drewsum/mTouch_Test/README.md

# mTouch_Test
Small PCB for playing around with PIC mTouch capacitive touch methods and USB serial ports

Firmware for U201 written in MPLABX, built using microchip's XC8 compiler

8/12/2018: PCB has been ordered via OSHPark
