drewsum/mTouch_Test/mTouch_Test/mTouch_Test_bom_.xlsx

Component | References | Value | Quantity Per PCB | Datasheet | Digi-Key PN | display_footprint | Dielectric | Voltage | Tolerance | Wattage
1 | C201 C204 C301 C303 C401 C402 C404 C406 C408 C409 C410 C501 C502 C503 C504 | 0.1uF | 15 |  | 399-6856-1-ND | 603 | X7R | 50V
2 | C601 | 100uF | 1 |  | 718-1031-1-ND | 7343 |  | 20V | 10%
3 | C202 C205 | 10nF | 2 |  | 490-4781-1-ND | 603 | X7R | 50V
4 | C203 C206 | 1nF | 2 |  | 399-3293-1-ND | 603 | X7R | 50V
5 | C602 C603 | 1uF | 2 |  | 478-5010-1-ND | 603 | X7R | 16V
6 | C403 | 4.7uF | 1 |  | 445-6969-1-ND | 805 | X7R | 16V
7 | C405 C407 | 47pF | 2 |  | 478-3692-1-ND | 603 | X7R | 50V
8 | C302 | 56000pF | 1 |  | 490-7747-1-ND | 2220 | X7R | 250VAC
9 | D601 | Green | 1 |  | 511-1308-1-ND | 603
10 | D201 D202 D203 D204 D205 D501 | Red | 6 |  | 511-1310-1-ND | 603
11 | D401 | Yellow | 1 |  | 511-1305-1-ND | 603
12 | J601 | Barrel_Jack_Switch | 1 | ~ | SC237-ND
13 | J501 | Prog | 1
14 | J401 | USB_B_Micro | 1 | ~ | 732-5960-1-ND
15 | L401 | 600R 0.5A | 1 | ~ | 732-1593-1-ND
16 | Q501 | BSS214NW | 1 | https://www.infineon.com/dgdl/Infineon-BSS214NW-DS-v02_02-en.pdf?fileId=db3a30431b3e89eb011b695aebc01bde | BSS214NWH6327XTSA1CT-ND
17 | Q601 | Si2319CDS | 1 | http://www.vishay.com/docs/66709/si2319cd.pdf | SI2319CDS-T1-GE3CT-ND
18 | R504 | 0 | 1 |  | P0.0GCT-ND | 603 |  |  | 1% | 1/10W
19 | R506 | 10 | 1 |  | 311-10.0HRCT-ND | 603 |  |  | 1% | 1/10W
20 | R201 R301 R302 R303 R304 R305 R306 R401 R501 R502 R503 R505 R601 | 10k | 13 |  | RHM10KADCT-ND | 603 |  |  | 1% | 1/10W
21 | R207 R208 R209 R210 R211 R404 R507 R602 | 1k | 8 |  | YAG2323CT-ND | 603 |  |  | 1% | 1/10W
22 | R202 R203 R204 R205 R206 | 220 | 5 |  | RHM220DCT-ND | 603 |  |  | 1% | 1/10W
23 | R402 R403 | 27 | 2 |  | P27.0HCT-ND | 603 |  |  | 1% | 1/10W
24 | U401 | 74LVC1G17 | 1 | http://www.ti.com/lit/sg/scyt129e/scyt129e.pdf | 296-16998-1-ND
25 | U502 | 74LVC1G86 | 1 | http://www.ti.com/lit/sg/scyt129e/scyt129e.pdf | 296-9854-1-ND
26 | U402 | FT234XD | 1 | http://www.ftdichip.com/Support/Documents/DataSheets/ICs/DS_FT234XD.pdf | 768-1178-1-ND
27 | U301 | ISO7331C | 1 | http://www.ti.com/lit/ds/symlink/iso7331c.pdf | 296-47261-1-ND
28 | U601 | MCP1700-3302E | 1 | http://ww1.microchip.com/downloads/en/DeviceDoc/20001826C.pdf | MCP1700T3302EMBCT-ND
29 | U201 | PIC18LF67K40-I_PT | 1 |  | PIC18LF67K40T-I/PTCT-ND
30 | U501 | TL331 | 1 | http://www.ti.com/lit/ds/symlink/tl331.pdf | 296-10168-1-ND
31 | U403 | TPD3S014DBVR | 1 | http://www.ti.com/lit/ds/symlink/tpd3s014.pdf | 296-38835-1-ND
32 | Z501 Z601 | BZT52C5V6S | 2 |  | BZT52C5V6S-TPMSCT-ND | SOD323 |  | 5.6V
Component Groups:
Component Count:
Fitted Components:
Number of PCBs:
Total components:
Schematic Version:
Schematic Date:
BoM Date:
Schematic Source:
KiCad Version:
