drewsum/mTouch_Test/(list of files, cad)

Other CAD files:
sfw/U201_Firmware/dist/default/production/U201_Firmware.production.obj
