drewsum/mTouch_Test/mTouch_Test/mTouch_Test.pdf

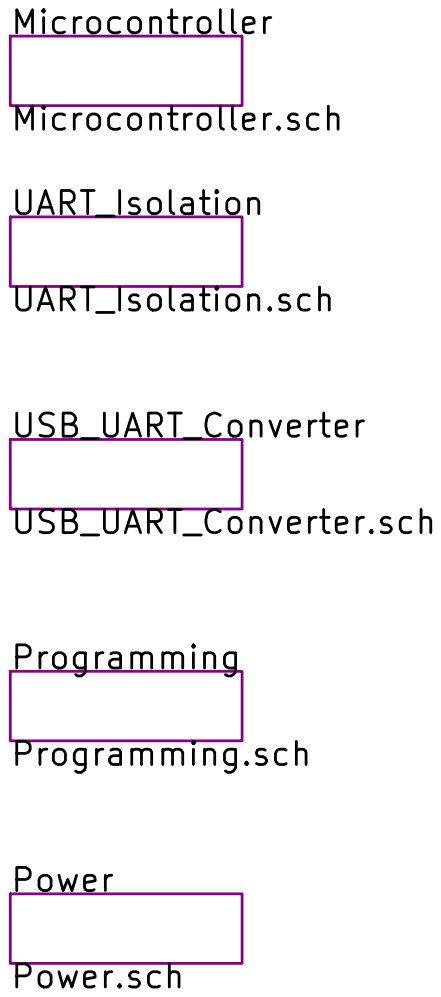
[picture p1: page 1]

Microcontroller Microcontroller.sch UART_Isolation UART_Isolation.sch USB_UART_Converter USB_UART_Converter.sch Programming

Programming.sch Power Power.sch

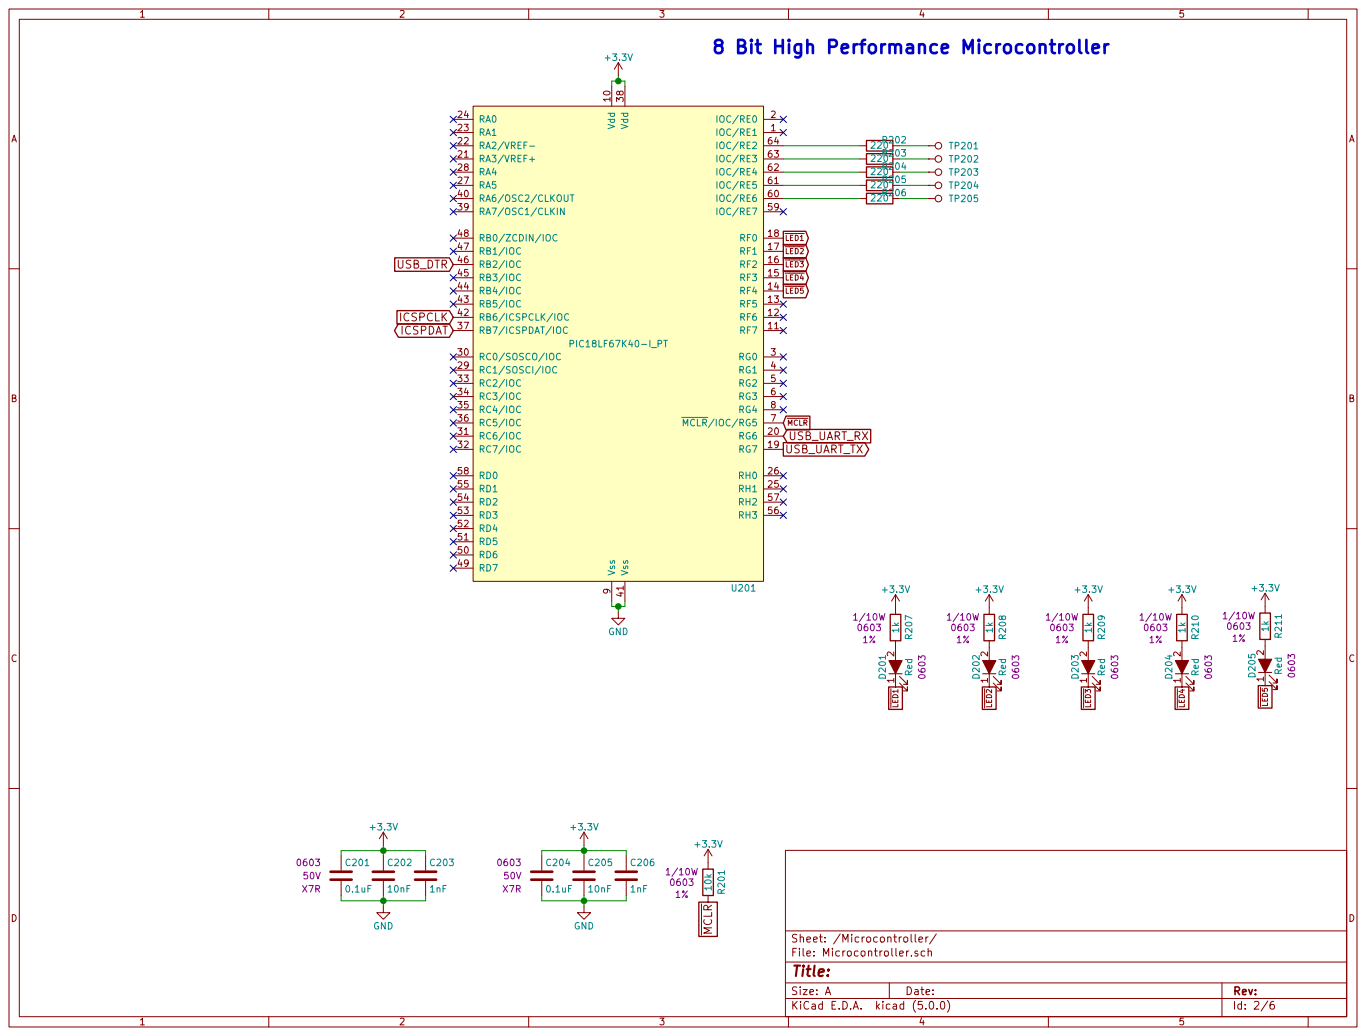
[picture p2: page 2]

8 Bit High Performance Microcontroller

Id: 2/6 Title: File: Microcontroller.sch Sheet: /Microcontroller/

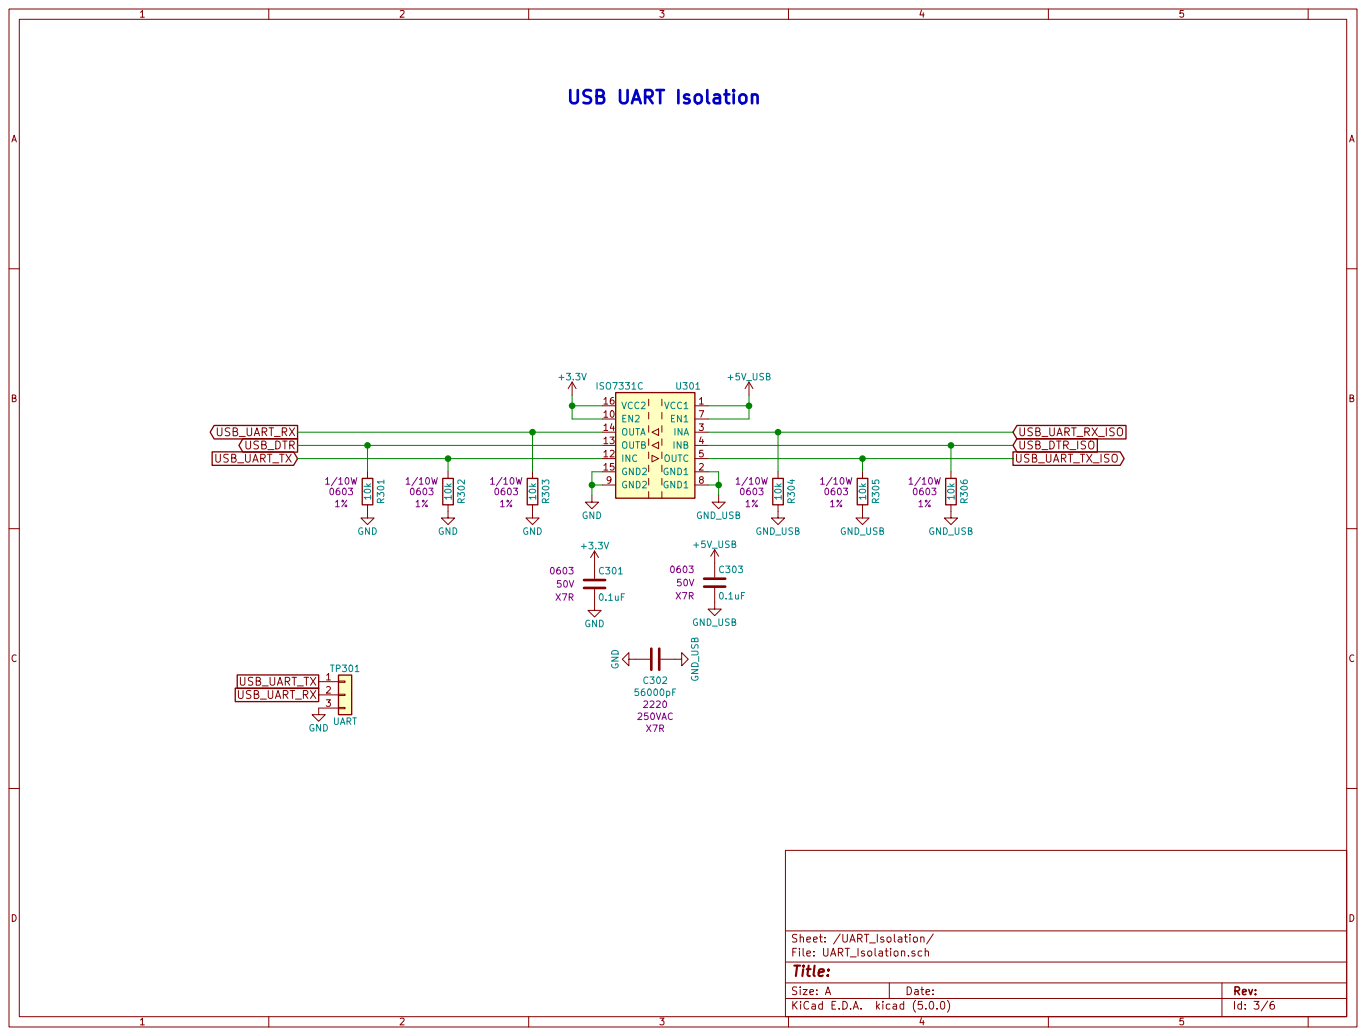
[picture p3: page 3]

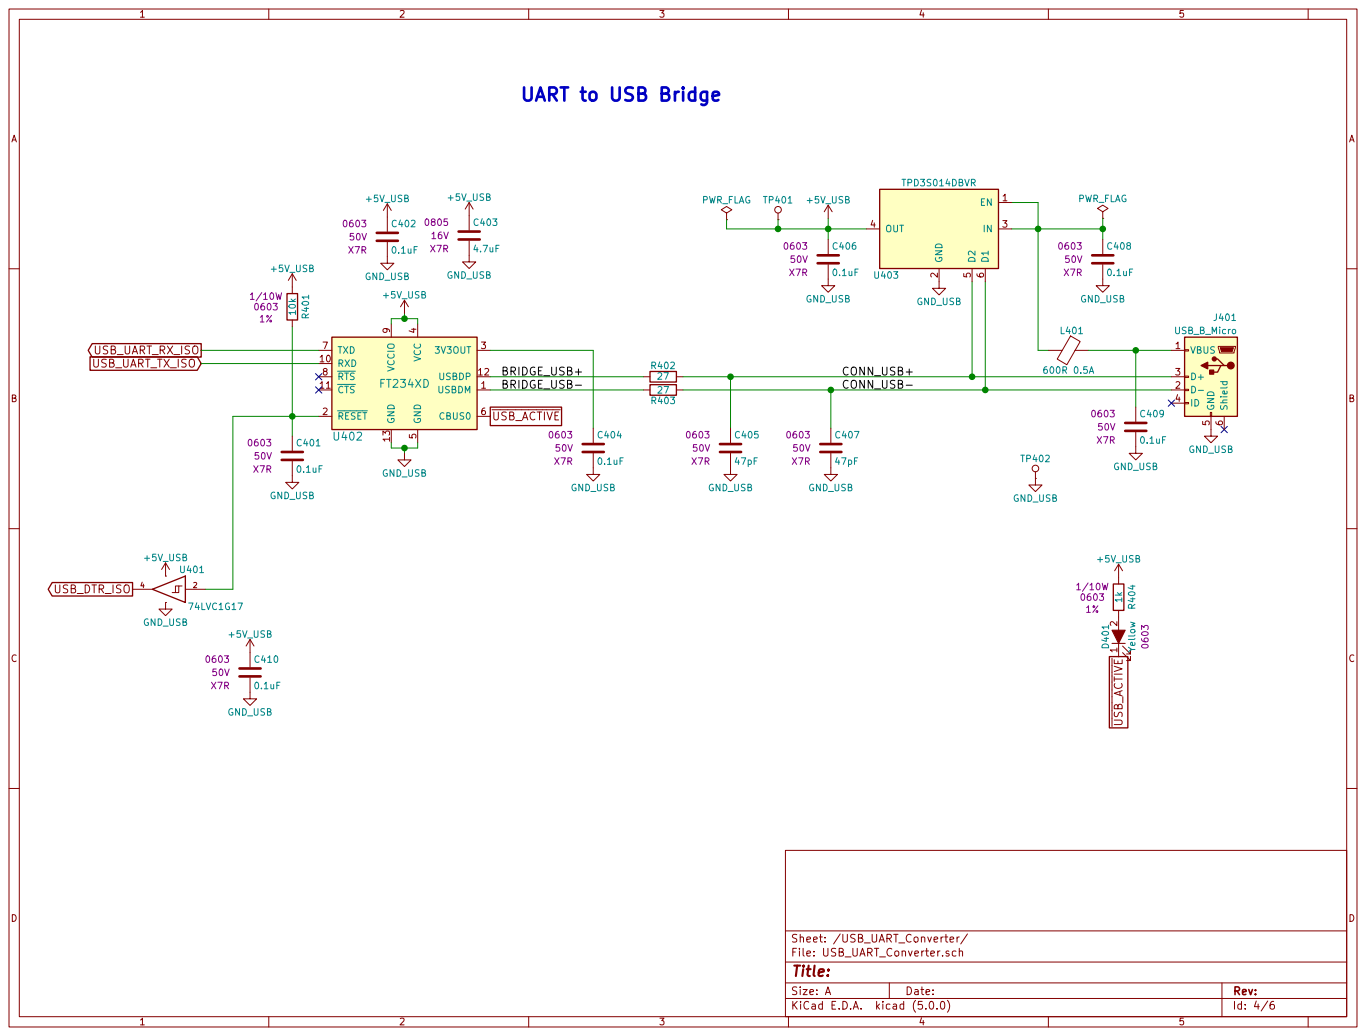
[picture p4: page 4]

J401 USB_B_Micro UART to USB Bridge

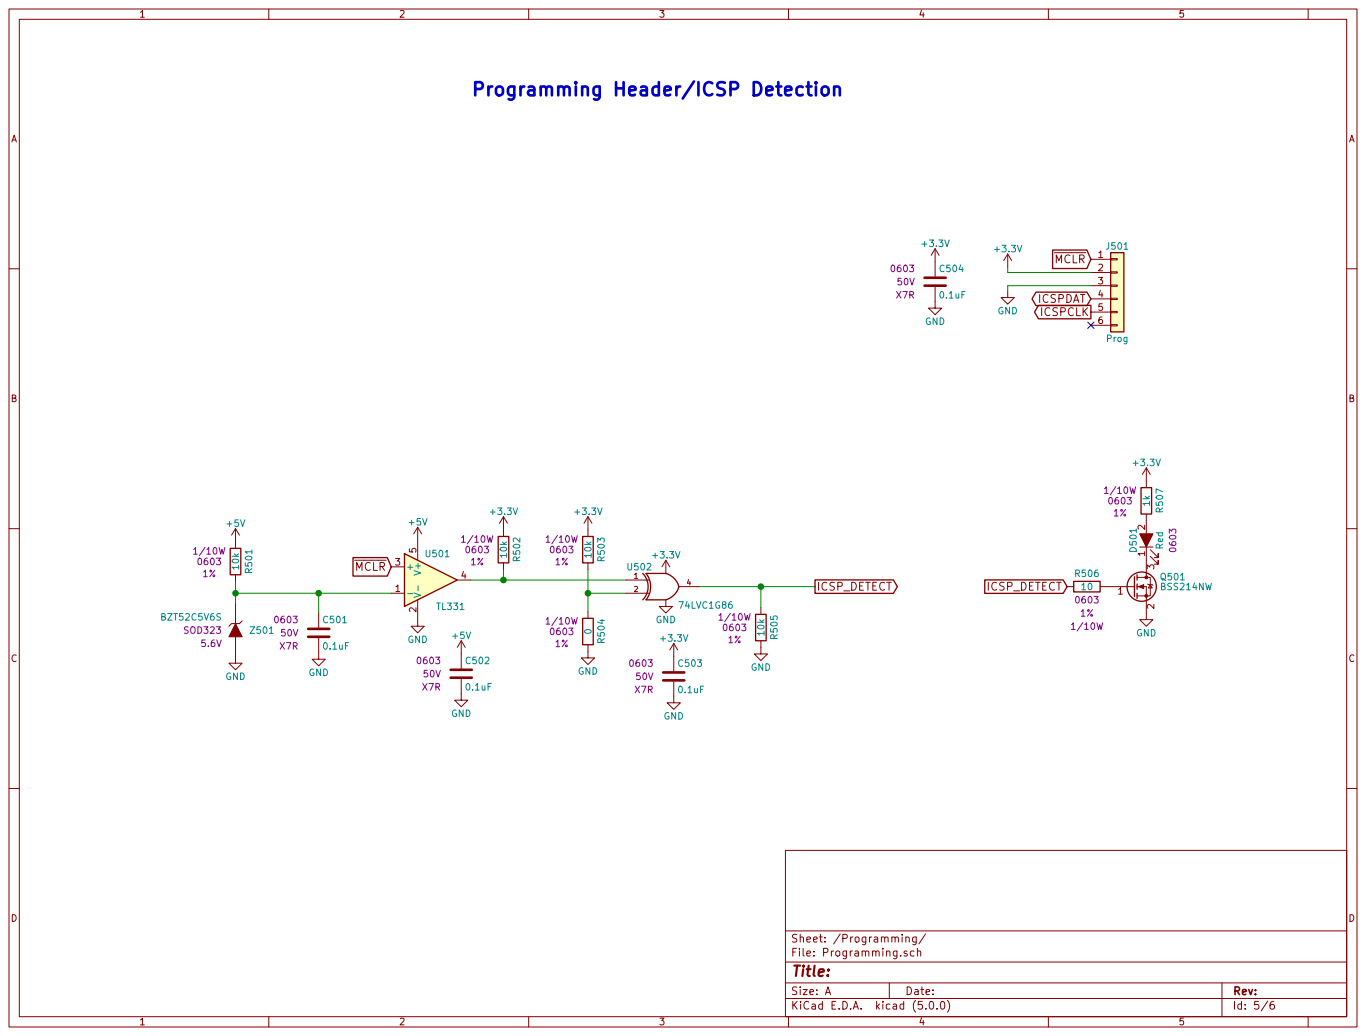
[picture p5: page 5]

74LVC1G86 Programming Header/ICSP Detection

ICSPDAT GND GND MCLR

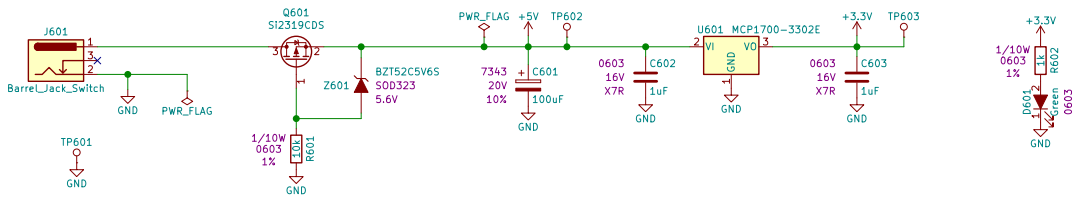
[picture p6: page 6]

Id: 6/6 Title: File: Power.sch Sheet: /Power/
