drewsum/mTouch_Test/mTouch_Test/mTouch_Test.kicad_pcb

## KiCad design mTouch_Test/mTouch_Test.kicad_pcb (2018-08-28)

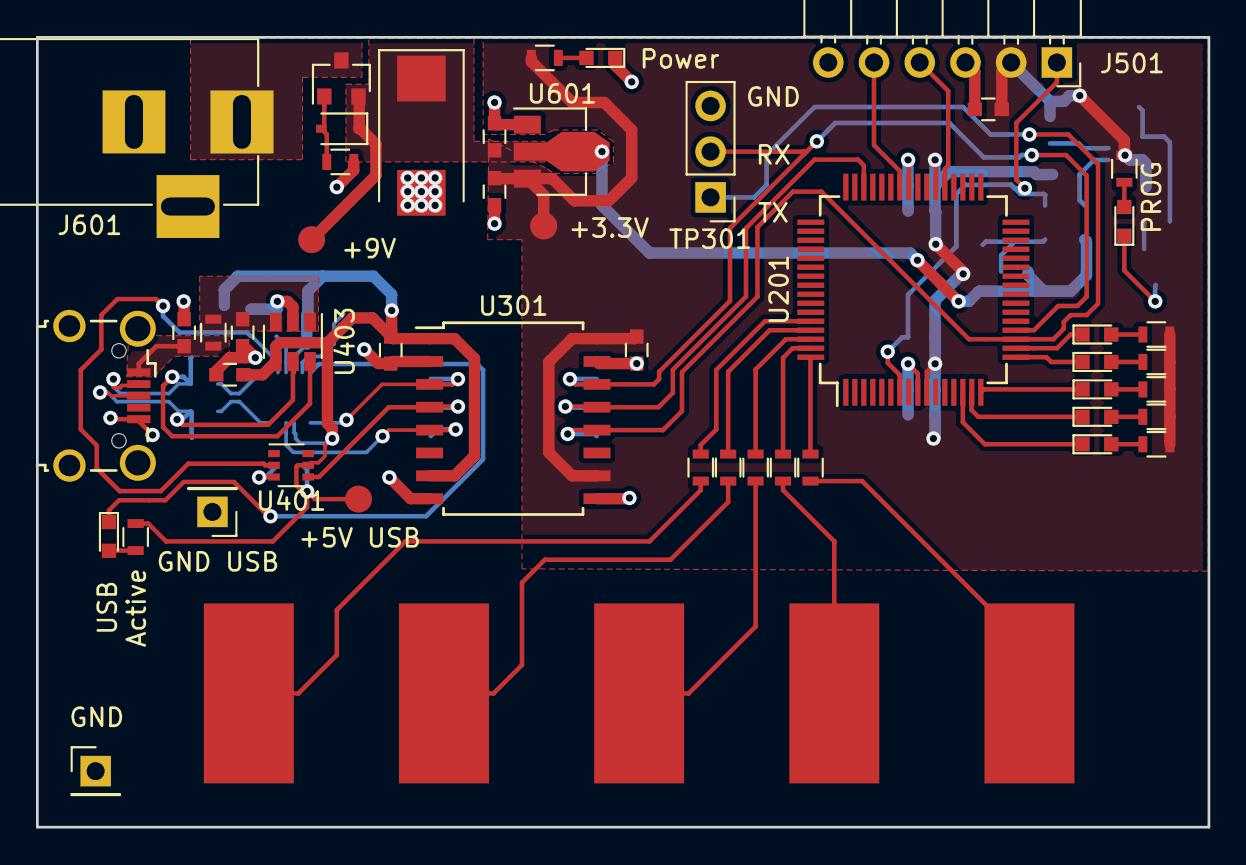
[picture p7: board mTouch_Test.kicad_pcb from above]

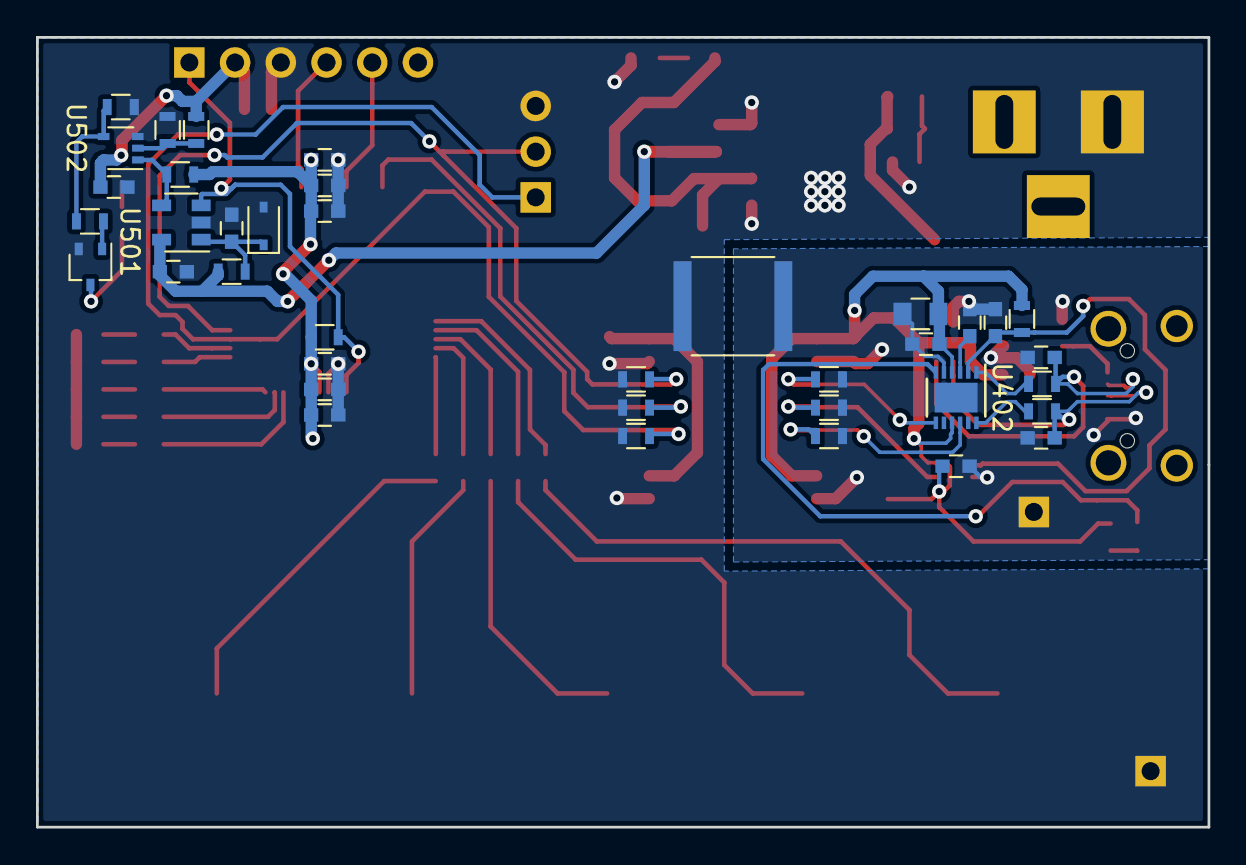
[picture p8: board mTouch_Test.kicad_pcb from below]

Board: 2 copper layers, 65.1 x 43.9 mm, 91 parts (38 on the bottom side), 54 nets.

Parts:
C201, C204, C301, C303, C401, C402, C404, C406, C408, C409, C410, C501, C502, C503, C504: 0.1uF; C_0603
C202, C205: 10nF; C_0603
C203, C206: 1nF; C_0603
C302: 56000pF; C_2220
C403: 4.7uF; C_0805
C405, C407: 47pF; C_0603
C601: 100uF; CP_Tantalum_Case-X_EIA-7343-43_Reflow
C602, C603: 1uF; C_0603
D201, D202, D203, D204, D205, D501: Red; LED_0603
D401: Yellow; LED_0603
D601: Green; LED_0603
J401: USB_B_Micro; USB_Micro-B_Wuerth-629105150521_CircularHoles
J501: Prog; PICKIT3_Header
J601: Barrel_Jack_Switch; BARREL_JACK
L401: 600R 0.5A; L_0603
Q501: BSS214NW; SOT-323_SC-70
Q601: Si2319CDS; SOT-23
R201, R301, R302, R303, R304, R305, R306, R401, R501, R502, R503, R505, R601: 10k; R_0603
R202, R203, R204, R205, R206: 220; R_0603
R207, R208, R209, R210, R211, R404, R507, R602: 1k; R_0603
R402, R403: 27; R_0603
R504: 0; R_0603
R506: 10; R_0603
TP201, TP202, TP203, TP204, TP205: TP; SolderWirePad_single_SMD_5x10mm
TP301: UART; Pin_Header_Straight_1x03_Pitch2.54mm
TP401, TP602, TP603: TP; Measurement_Point_Round-SMD-Pad_Small
TP402, TP601: TP; Pin_Header_Straight_1x01_Pitch2.54mm
U201: PIC18LF67K40-I_PT; TQFP-64_10x10mm_Pitch0.5mm
U301: ISO7331C; SOIC-16W_7.5x10.3mm_Pitch1.27mm
U401: 74LVC1G17; SOT-363_SC-70-6
U402: FT234XD; DFN-12-1EP_3x3mm_Pitch0.45mm
U403: TPD3S014DBVR; SOT-23-6
U501: TL331; SOT-23-5
U502: 74LVC1G86; SOT-353_SC-70-5
U601: MCP1700-3302E; SOT-89-3
Z501, Z601: BZT52C5V6S; D_SOD-323

Connections:
+3V3: C201.1, C202.1, C203.1, C204.1, C205.1, C206.1, C301.1, C503.1, C504.1, C603.1, J501.2, R201.1, R207.1, R208.1, R209.1, R210.1, R211.1, R502.1, R503.1, R507.1, R602.1, TP603.1, U201.10, U201.38, U301.10, U301.16, U502.5, U601.3
+5V_USB: C303.1, C402.1, C403.1, C406.1, C410.1, R401.1, R404.1, TP401.1, U301.1, U301.7, U401.5, U402.4, U402.9, U403.4
+9V: C502.1, C601.1, C602.1, Q601.2, R501.1, TP602.1, U501.5, U601.2, Z601.1
/USB_UART_Converter/BRIDGE_USB+: R402.1, U402.12
/USB_UART_Converter/BRIDGE_USB-: R403.2, U402.1
/USB_UART_Converter/CONN_USB+: C405.1, J401.3, R402.2, U403.5
/USB_UART_Converter/CONN_USB-: C407.1, J401.2, R403.1, U403.6
GND: C201.2, C202.2, C203.2, C204.2, C205.2, C206.2, C301.2, C302.2, C501.2, C502.2, C503.2, C504.2, C601.2, C602.2, C603.2, D601.1, J501.3, J601.2, Q501.2, R301.2, R302.2, R303.2, R504.2, R505.2, R601.2, TP301.3, TP601.1, U201.9, U201.41, U301.9, U301.15, U501.2, U502.3, U601.1, Z501.2
GND_USB: C302.1, C303.2, C401.2, C402.2, C403.2, C404.2, C405.2, C406.2, C407.2, C408.2, C409.2, C410.2, J401.5, R304.2, R305.2, R306.2, TP402.1, U301.2, U301.8, U401.3, U402.5, U402.13, U403.2
ICSPCLK: J501.5, U201.42
ICSPDAT: J501.4, U201.37
ICSP_DETECT: R505.1, R506.2, U502.4
unnamed: C401.1, R401.2, U401.2, U402.2
unnamed: C404.1, U402.3
unnamed: C408.1, L401.2, U403.1, U403.3
unnamed: C409.1, J401.1, L401.1
unnamed: C501.1, R501.2, U501.1, Z501.1
unnamed: D201.2, R207.2
unnamed: D202.2, R208.2
unnamed: D203.2, R209.2
unnamed: D204.2, R210.2
unnamed: D205.2, R211.2
unnamed: D401.2, R404.2
unnamed: D501.1, Q501.3
unnamed: D501.2, R507.2
unnamed: D601.2, R602.2
unnamed: J601.1, Q601.3
unnamed: Q501.1, R506.1
unnamed: Q601.1, R601.1, Z601.2
unnamed: R202.1, U201.64
unnamed: R202.2, TP201.1
unnamed: R203.1, U201.63
unnamed: R203.2, TP202.1
unnamed: R204.1, U201.62
unnamed: R204.2, TP203.1
unnamed: R205.1, U201.61
unnamed: R205.2, TP204.1
unnamed: R206.1, U201.60
unnamed: R206.2, TP205.1
unnamed: R502.2, U501.4, U502.1
unnamed: R503.2, R504.1, U502.2
USB_DTR: R301.1, U201.46, U301.13
USB_DTR_ISO: R306.1, U301.4, U401.4
USB_UART_RX: R303.1, TP301.2, U201.20, U301.14
USB_UART_RX_ISO: R304.1, U301.3, U402.7
USB_UART_TX: R302.1, TP301.1, U201.19, U301.12
USB_UART_TX_ISO: R305.1, U301.5, U402.10
~LED1: D201.1, U201.18
~LED2: D202.1, U201.17
~LED3: D203.1, U201.16
~LED4: D204.1, U201.15
~LED5: D205.1, U201.14
~MCLR: J501.1, R201.2, U201.7, U501.3
~USB_ACTIVE: D401.1, U402.6
