drewsum/mTouch_Test/(commit log)

2018-08-11 Imported a few schematic sheets from VFD_Clock project
    [Microcontroller.sch, UART_Isolation.sch, USB_UART_Converter.sch, mTouch_Test.kicad_pcb, mTouch_Test.sch]
2018-08-11 Added programming sheet, replaced a lot of messed up symbols
    [Microcontroller.sch, Programming.sch, UART_Isolation.sch, USB_UART_Converter.sch, mTouch_Test.sch]
2018-08-12 Finished schematic, assigned DigiKey PNs
    [Microcontroller.sch, Programming.sch, UART_Isolation.sch, USB_UART_Converter.sch, mTouch_Test.sch]
2018-08-12 Assigned PCB footprints, generated netlist
    [Microcontroller.sch, Programming.sch, UART_Isolation.sch, USB_UART_Converter.sch]
2018-08-12 Added PDF
    [Power.sch]
2018-08-12 USB circuits arranged
    [USB_UART_Converter.sch, mTouch_Test.kicad_pcb]
2018-08-12 Arranged micro
    [mTouch_Test.kicad_pcb]
2018-08-12 Arranged programing detection circuits
    [mTouch_Test.kicad_pcb]
2018-08-12 Finished fisrt pass of arranging parts
    [mTouch_Test.kicad_pcb]
2018-08-12 Added board edge
    [mTouch_Test.kicad_pcb]
2018-08-12 Routed a considerable portion of the board
    [mTouch_Test.kicad_pcb]
2018-08-12 Finished Routing
    [mTouch_Test.kicad_pcb]
2018-08-12 Added Bill of Materials
    [mTouch_Test_bom_.xlsx]
2018-08-28 Changed +9V Net to +5V due to errors in LDO input voltage constraints
    [Power.sch, Programming.sch, mTouch_Test.kicad_pcb, mTouch_Test.sch, mTouch_Test_bom_.xlsx]
2018-08-28 Added firmware project for U201 firmware
    [U201_Firmware.production.obj]
2018-08-28 Added ring buffer interface APIs, imported from an earlier project. Altered all EUSART variable references and macros to match EUSART2 as this module is used for USB debug communication
    [U201_Firmware.production.obj]
2018-08-28 Edited ring buffer interface LUT to match certain parameters of the circuit design
    [U201_Firmware.production.obj]
2018-08-28 Added IDN SCPI command to supported serial commands, removed LED blinking test
    [U201_Firmware.production.obj]
2018-08-28 Added MCC generated mTouch files
    [U201_Firmware.production.obj]
2018-08-28 Added button press functionality into main loop
2018-08-28 Added functionality to interface mTouch buttons with serial debug
    [U201_Firmware.production.obj]
2018-08-28 Edited reset message
    [U201_Firmware.production.obj]
2018-08-28 Added USB DTR interrupt functionality, and changed eusart ready flag from uint8_t to bit data type
    [U201_Firmware.production.obj]
2018-09-02 Rewrote a lot of code, got the firmware to the point I want it
    [U201_Firmware.production.obj]
